bill538/IOT_Smart_Switch/(list of files, drawings)

Other design files:
IOT_Smart_Switch.dsn
