bill538/IOT_Smart_Switch/(commit log)

2016-01-05 Initial update.
    [IOT_Smart_Switch-20160104.dsn]
2016-01-14 Minor diagram changes
    [IOT_Smart_Switch-20160104.dsn]
2016-01-14 Fixed named in spark.json file replacing - with _
    [IOT_Smart_Switch.cpp]
2016-01-16 Adding Spart TimeAlarm code so I have timer code options.
2016-01-16 Updated the electrical drawing to include pull up resistors on the I2C bus.
    [IOT_Smart_Switch.dsn]
2016-01-20 Updated IOT_Smart_Switch.ino. Cleaned up lcd output for debugging. Added in Cloud/RESTapi function RelayInChg
2016-02-02 Added in REST API but will remove becuase it looks to be unstable. Will start testing Webdunio
    [IOT_Smart_Switch.ino]
2016-02-05 Replaced Rest API web server with Webunio becuase more stable
    [IOT_Smart_Switch.ino]
2016-02-05 HTML Page only showing RelayIn State
2016-02-11 Working but need to put in pin mode checks nexts
2016-02-12 fixed pin mode issues getting close to first .5 version
    [IOT_Smart_Switch.ino]
2016-02-13 Phyical switch, Web server and Timer are not all working
2016-02-18 Fixed issue with Switch 4.
    [IOT_Smart_Switch.ino]
2016-02-20 Moved the LCD updating tasks to a timer becuase timers are threaded.
2016-03-04 Moved the phyical switch monitoring to a software timer every 100th sec.
2016-03-04 Fixed style css dor font size is consistent
    [IOT_Smart_Switch.ino]
2016-03-04 Added Case work screen shot.
