bill538/IOT_Smart_Switch/(notices)

Notices in the files:
firmware/IOT_Smart_Switch.cpp:
Public License, but WITHOUT ANY WARRANTY; without even the implied
